ustajan/peak_detector_mca/README.md

# MCA with a peak detector and MCU

Author:  Areg Danagoulian \
Copyright:  Areg Danagoulian, 2024

This repostitory contains the documentation, schematics, and the arduino code for a simple, cheap MCU using a peak detector and a small attiny85 for readout.
